CreepyPigeon/ESP32-TV-Mask/Aspose.Words.ff0362dd-abbd-410b-9df2-b9de3405f485.005.png

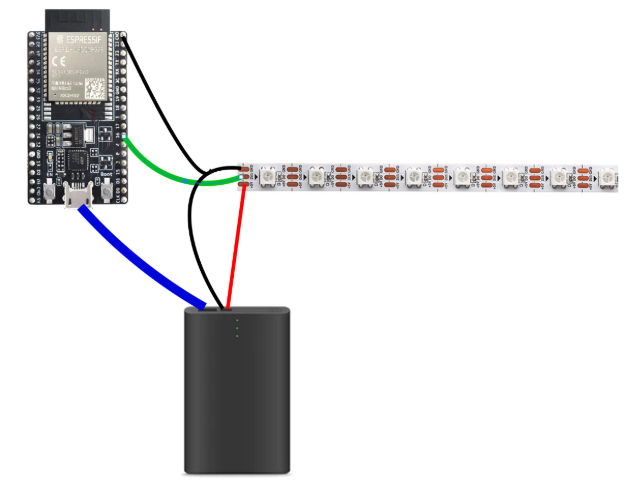
Aspose.Words.ff0362dd-abbd-410b-9df2-b9de3405f485.005.png
